williamthayer/Daisy_Board_DC/Daisy Board DC.docx

### Daisy Board DC

Compact, ESP32-powered motor driver with integrated IMU for robotics and IoT projects

Key Features:

- Controls DC motors up to 7A continuous, 10A peak.
- Operates with input voltages between 10V and 28V.
- Compact design (1.2" x 1.8") with various communication options: 5V I2C, CAN bus, GPIO.
- Onboard 6-axis IMU for motion tracking and feedback.

Manufacturer: Wilson Fabrication

### Table of Contents

1. Overview
2. Key Features
3. Specifications
4. Pinouts
5. Functional Description
6. Assembly Notes
7. Ordering Information
8. Contact Information

#### 1. Overview

The Daisy Board DC is a feature-rich, compact motor control solution tailored for robotics and smart projects. Powered by the ESP32-C3 microcontroller, this board integrates CAN bus communication for daisy-chaining multiple devices and I2C for easy expansion with sensors or additional modules.

An onboard 6-axis IMU (LSM6DS3TR-C) provides precise motion tracking and orientation feedback, making the board ideal for robotics applications requiring advanced control. The integrated motor driver (VNH7100BASTR) supports up to 7A continuous current and features current-sensing capabilities for real-time monitoring and control.

The Daisy Board DC is designed for maximum flexibility, with connectors for CAN bus, I2C, and GPIO, and configurable CAN addressing using a 4-position DIP switch. This robust solution is well-suited for IoT devices, smart home systems, and robotics projects requiring efficient motor control in a small footprint.

#### 2. Key Features

- Power: Accepts 10V to 28V input, supporting up to 7A continuous current (10A peak).
- Interfaces:
  - CAN Bus (Low, High, 5V, GND)
  - I2C (SCL, SDA, 5V, GND)
  - GPIO (1 digital, 1 analog, 3.3V, GND)
- Onboard Components:
  - Motor Driver: VNH7100BASTR
  - CAN Transceiver: TJA1050T_CM
  - IMU: LSM6DS3TR-C (6-axis)
  - Microcontroller: ESP32-C3
- Feedback: Current sense resistor and 6-axis IMU for enhanced control.
- Flexibility: Includes a 4-position DIP switch to configure CAN addresses.

#### 3. Specifications

- Input Voltage: 10V–28V
- Max Continuous Current: 7A (10A peak)
- PCB Dimensions: 1.2" x 1.8"
- Temperature Range: -40°C to 85°C
- Pin Connectors:
  - XT30 (power in/out and motor output)
  - J8 header for GPIO2, 5V, and GND
- Capacitor and Connectors:
  - Polarized XT30 connectors and capacitor, clearly labeled for correct orientation.

#### 4. Pinouts

CAN Bus:

- CAN LOW
- CAN HIGH
- 5V
- GND

I2C:

- SCL
- SDA
- 5V
- GND

GPIO:

- Digital Input 1
- Analog Input 1
- 3.3V
- GND

#### 5. Functional Description

The Daisy Board DC provides robust motor control with precise feedback capabilities.

- Motor Driver: The VNH7100BASTR motor driver supports high current loads and features current-sensing capabilities. The sense resistor provides 0.125mA per amp to monitor current.
- Current Sensing: A user-solderable sense resistor enables current feedback, tailored to the user’s maximum current needs.
- 6-axis IMU: The LSM6DS3TR-C IMU provides real-time orientation and motion data for advanced robotics applications.
- Communication:
  - CAN Bus allows daisy-chaining of multiple boards.
  - I2C provides expansion for sensors and additional I/O.
- Configurability: The onboard DIP switch allows quick CAN address changes without firmware updates.

#### 6. Assembly Notes

The PCB comes with the following components pre-assembled:

- Motor driver, CAN transceiver, IMU, and basic passives.

User-solderable components:

- 5V regulator
- ESP32 module
- XT30 connectors (optional: bare wire for cost/space savings)
- Sense resistor and large capacitor for motor driver

Ensure proper orientation of the polarized capacitor and XT30 connectors, which are clearly labeled on the PCB.

#### 7. Ordering Information

- Part Number: DaisyBoardDC-ESP32
- Manufacturer: Wilson Fabrication
- Customization Options: Bare PCB or fully assembled (contact for details).

### 8. Sense Resistor Sizing Guide

The Daisy Board DC features a current feedback system utilizing a sense resistor. The motor driver supplies 0.125 mA per amp to the resistor, generating a voltage that corresponds to the motor current. The target voltage at maximum current should be 3V.

#### Example Calculation

If the motor’s maximum current is 10A:

In this case, a resistor with a value of 2.4kΩ is ideal, but standard resistor values like 2.2kΩ or 2.7kΩ can also be used.

#### Lookup Table

Max Current (A) | Target Voltage (V) | Calculated Resistor (kΩ) | Standard Resistor (kΩ)
5 | 3.0 | 4.8 | 4.7
7 | 3.0 | 3.43 | 3.3 or 3.6
10 | 3.0 | 2.4 | 2.2 or 2.7

#### 9. Contact Information

For inquiries, please contact:

- Email: Lucas@wilsonfabrication.net
- Website: https://wilsonfabrication.com/contact-us/
