williamthayer/Daisy_Board_DC/BOM.xlsx

Comment | Designator | Footprint | JLCPCB Part #（optional）
300 | R9 | R_0805_2012Metric
220 | R8 | R_0805_2012Metric | C17557
220 | R7 | R_0805_2012Metric | C17557
NH-B2020RGBA-HF | LED1 | NHB2020RGBAHF | C2874116
PTV09A-4225F-B104 | R1 | TRIM_PT15NV15-102A1010-S
Arduino_Mini_Socket | A1 | Clone_Pro_Mini_Socket_NoSPH
1k Resistor | R2,R3,R4,R5 | R_0805_2012Metric
Data Out | H8 | Hole
CLK Out | H7 | Hole
L78M05ABDT-TR | IC2 | L78M05ABDTTR | C58069
GND | H2 | Hole
Rsense | R6 | R_Axial_DIN0204_L3.6mm_D1.6mm_P5.08mm_Horizontal
24V | H1 | Hole
CLK IN | H6 | Hole
VNH7100BASTR | IC1 | SOIC127P600X175-16N | C503078
M2 | H4 | Hole
Data In | H5 | Hole
M1 | H3 | Hole
