williamthayer/Daisy_Board_DC/JLCbom.xls

Comment | Designator | Footprint | JLCPCB Part #
10nF | C3 | 0805 | C1710
VNH7100BASTR | IC1 | SOIC127P600X175-16N | C503078
8.2k | R1,R13,R14 | 0402 | C25924
Conn_01x02_Pin | J6 | JST_SH_BM02B-SRSS-TB_1x02-1MP_P1.00mm_Vertical | C160402
Conn_01x03_Pin | J5 | JST_SH_SM03B-SRSS-TB_1x03-1MP_P1.00mm_Horizontal | C160403
SM04B-SRSS-TB | J1,J2 | JST_SH_SM04B-SRSS-TB_1x04-1MP_P1.00mm_Horizontal | C160404
TJA1050T_CM | IC2 | SOIC127P600X175-8N | C19723770
100nF | C2,C6 | 0805 | C49678
DSHP04TJGER | SW1 | SW_DIP_SPSTx04_Slide_KingTek_DSHP04TJ_W5.25mm_P1.27mm_JPin | C3293150
2.2k | R11 | 0402 | C25879
30pF | C4,C5 | 0805 | C107114
120 | R7,R8 | 0402 | C25079
NH-B2020RGBA-HF | LED1 | NHB2020RGBAHF | C2874116
165 | R9 | 0402 | C166668
1.1k | R12,R2,R3,R4,R5 | 0402 | C25860
3.9k | R10 | 0402 | C51721
