williamthayer/Daisy_Board_DC/Arduino_Motor_Shield Knee Shape Rev 3/DC_ESP32_Motor_Board_CAN.step

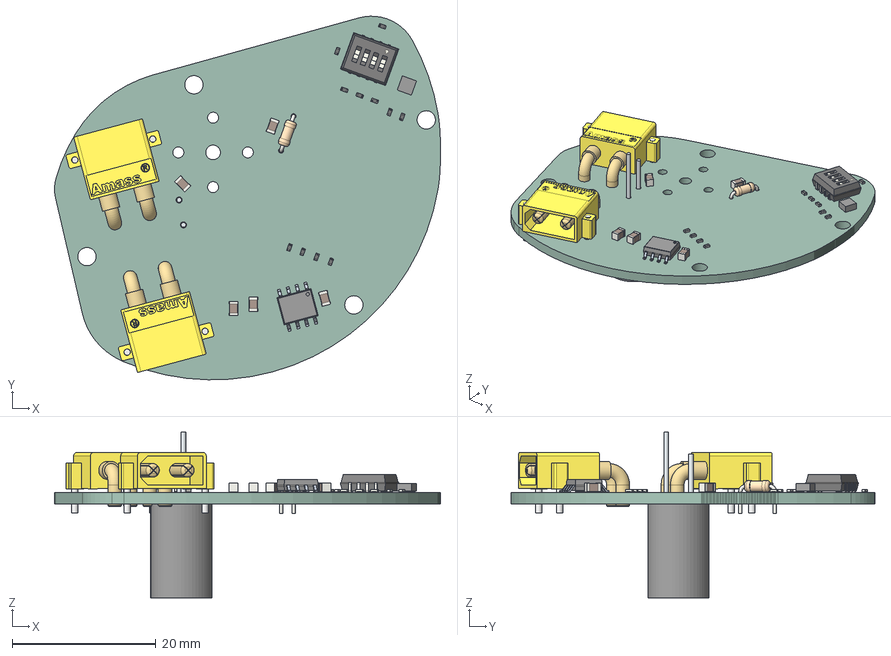
[picture p1: CAD file, 2024-10-24]
Arduino_Motor_Shield Knee Shape Rev 3/DC_ESP32_Motor_Board_CAN.step
53.6 x 50.5 x 23.0 mm
Amass_XT30PW-M_pcb solder x 2
R_0402_1005Metric x 11
C_0805_2012Metric x 5
R_Axial_DIN0204_L36mm_D16mm_P508mm_Horizontal
ASSEMBLY x 3
SW_DIP_SPSTx04_Slide_KingTek_DSHP04TJ_W525mm_P127mm_JPin
_autosave-Arduino_Motor_Shield_PCB
