williamthayer/Daisy_Board_DC/DC_ESP32_Motor_Board_CAN.kicad_pcb

## KiCad design DC_ESP32_Motor_Board_CAN.kicad_pcb (2025-01-15)

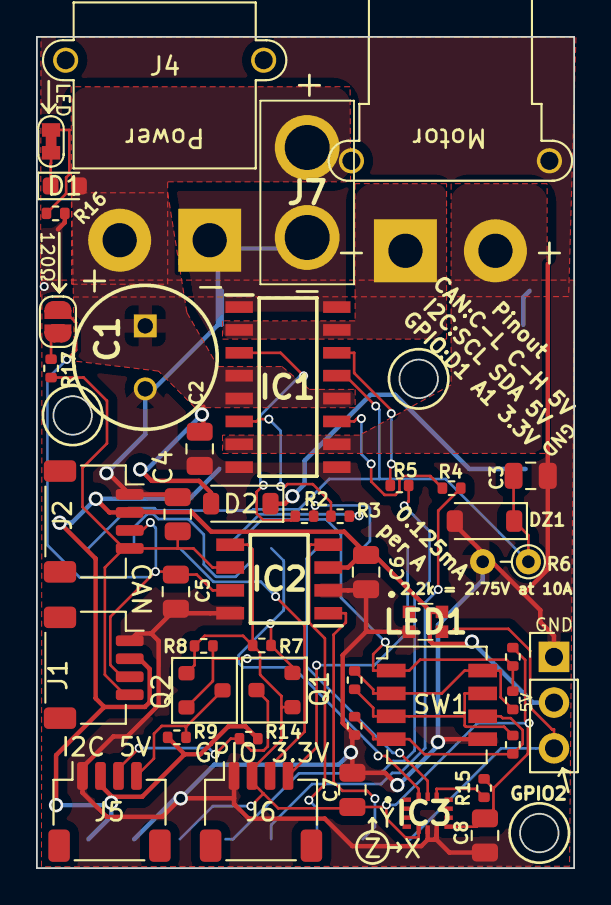
[picture p2: board DC_ESP32_Motor_Board_CAN.kicad_pcb from above]

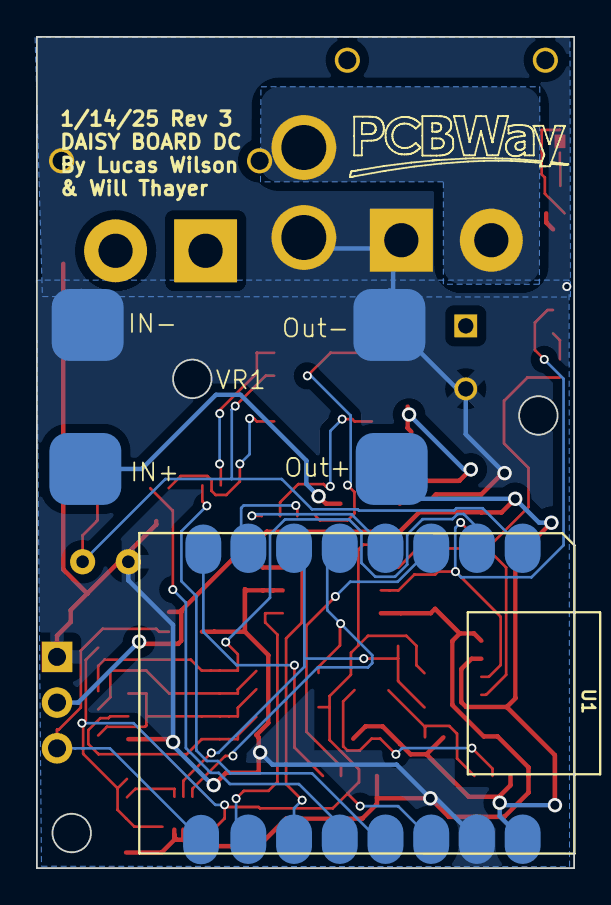
[picture p3: board DC_ESP32_Motor_Board_CAN.kicad_pcb from below]

Board: 2 copper layers, 29.8 x 46.2 mm, 47 parts (2 on the bottom side), 35 nets.

Parts:
C1: EEU-FK1E271; CAPPRD350W65D800H1300
C2, C6, C7, C8: 100nF; C_0805_2012Metric
C3: 10nF; C_0805_2012Metric
C4, C5: 30pF; C_0805_2012Metric
D1: KT-0603R; LED_0603_1608Metric
D2: SS34; D_SOD-123
DZ1: MM1Z3V3; D_SOD-123
IC1: VNH7100BASTR; SOIC127P600X175-16N
IC2: TJA1050T_CM; SOIC127P600X175-8N
IC3: LSM6DS3TR-C; LSM6DS3USTR
J1, J2, J5, J6: SM04B-SRSS-TB; JST_SH_SM04B-SRSS-TB_1x04-1MP_P1.00mm_Horizontal
J3: XT30PB; xt30_90_Female
J4: XT30PB; Xt30 Horizontal
J7: XT30PB
J8: Conn_01x03_Pin; PinHeader_1x03_P2.54mm_Vertical
JP1: SolderJumper_2_Open; SolderJumper-2_P1.3mm_Open_RoundedPad1.0x1.5mm
JP2: SolderJumper_2_Open; Jumper Connected 2 Pin Small
LED1: WS2812C-2020; WS2812C2020
Q1, Q2: BSS138; SOT-23
R1: 22k; R_0402_1005Metric
R2, R3, R4, R5: 1.1k; R_0402_1005Metric
R6: Rsense; R_Axial_DIN0204_L3.6mm_D1.6mm_P2.54mm_Vertical
R7, R8, R9, R10, R13, R14, R15: 10k; R_0402_1005Metric
R11: 4.7k; R_0402_1005Metric
R12: 2.2k; R_0402_1005Metric
R16: 1.5k; R_0402_1005Metric
R17: 120; R_0402_1005Metric
SW1: DSHP04TJGER; SW_DIP_SPSTx04_Slide_Copal_CHS-04A_W5.08mm_P1.27mm_JPin
U1: MOUDLE-SEEEDUINO-XIAO-ESP32C3; ESP32-C3 16 Pin Super Mini
VR1: EY9 reg board

Connections:
+3.3V: C7.1, C8.1, IC2.5 (VREF), IC3.5 (VDDIO), IC3.8 (VDD), J6.2, Q1.1 (G), Q2.1 (G), R7.2, R8.2, R13.1, R15.2, U1.14 (3.3V)
+5V: C6.1, IC2.3 (VCC), J1.2, J2.2, J5.2, J8.2, LED1.4 (VDD), R9.2, R14.2, U1.16 (5V), VR1.2 (Out+)
+24V: C1.1 (+), C2.1, D1.2 (A), D2.2 (A), IC1.4 (VCC_1), IC1.5 (VCC_2), IC1.12 (VCC_3), J4.2, J7.2
/OUTA: IC1.2 (OUTA_1), IC1.15 (OUTA_2), J3.1
/OUTB: IC1.7 (OUTB_1), IC1.10 (OUTB_2), J3.2
/SCL5: J5.4, Q2.3 (D), R9.1
/SDA5: J5.3, Q1.3 (D), R14.1
CANH: C5.1, IC2.7 (CANH), J1.3, J2.3, JP1.2 (B)
CANL: C4.2, IC2.6 (CANL), J1.4, J2.4, R17.1
CANRX: IC2.4 (RXD), U1.11 (PA6_A10_D10_MOSI)
CANTX: IC2.1 (TXD), U1.10 (PA5_A9_D9_MISO)
DipV: R1.2, R13.2, SW1.1, U1.2 (PA4_A1_D1)
GND: C1.2 (-), C2.2, C3.2, C4.1, C5.2, C6.2, C7.2, C8.2, DZ1.2 (A), IC1.1 (GNDA_1), IC1.8 (GNDB_1), IC1.9 (GNDB_2), IC1.16 (GNDA_2), IC2.2 (GND), IC2.8 (S), IC3.6 (GND_1), IC3.7 (GND_2), J1.1, J2.1, J4.1, J5.1, J6.1, J7.1, J8.1, LED1.2 (GND), R6.2, R12.1, R16.1, SW1.5, U1.15 (GND), VR1.1 (Out-), VR1.4 (In-)
GPIO_1: J6.4, U1.8 (PB09_A7_D7_RX)
GPIO_2: J8.3, LED1.3 (DI), U1.9 (PA7_A8_D8_SCK)
GPIO_A: J6.3, U1.3 (PA10_A2_D2)
INA: R2.1, U1.7 (PB08_A6_D6_TX)
INB: R3.1, U1.4 (PA11_A3_D3)
unnamed: D1.1 (K), JP2.2 (B)
unnamed: D2.1 (K), VR1.3 (In+)
unnamed: IC1.3 (INA), R2.2
unnamed: IC1.6 (INB), R3.2
unnamed: IC1.11 (PWM), R4.1
unnamed: IC1.14 (SEL0), R5.1
unnamed: IC3.12 (CS), R15.1
unnamed: JP1.1 (A), R17.2
unnamed: JP2.1 (A), R16.2
unnamed: R1.1, R10.2, SW1.2, SW1.8
unnamed: R10.1, R11.2, SW1.3, SW1.7
unnamed: R11.1, R12.2, SW1.4, SW1.6
PWM: R4.2, U1.12 (PA6_A11_D11)
RSENSE: C3.1, DZ1.1 (K), IC1.13 (CS), R6.1, U1.1 (PA02_A0_D0)
SCL: IC3.13 (SCL), Q2.2 (S), R8.1, U1.6 (PA9_A5_D5_SCL)
SDA: IC3.14 (SDA), Q1.2 (S), R7.1, U1.5 (PA8_A4_D4_SDA)
SEL: R5.2, U1.13 (PA6_A12_D12)
