williamthayer/Daisy_Board_DC/Arduino_Motor_Shield Knee Shape Rev 3/DC_ESP32_Motor_Board_CAN.kicad_pcb

## KiCad design Arduino_Motor_Shield Knee Shape Rev 3/DC_ESP32_Motor_Board_CAN.kicad_pcb (2024-10-24)

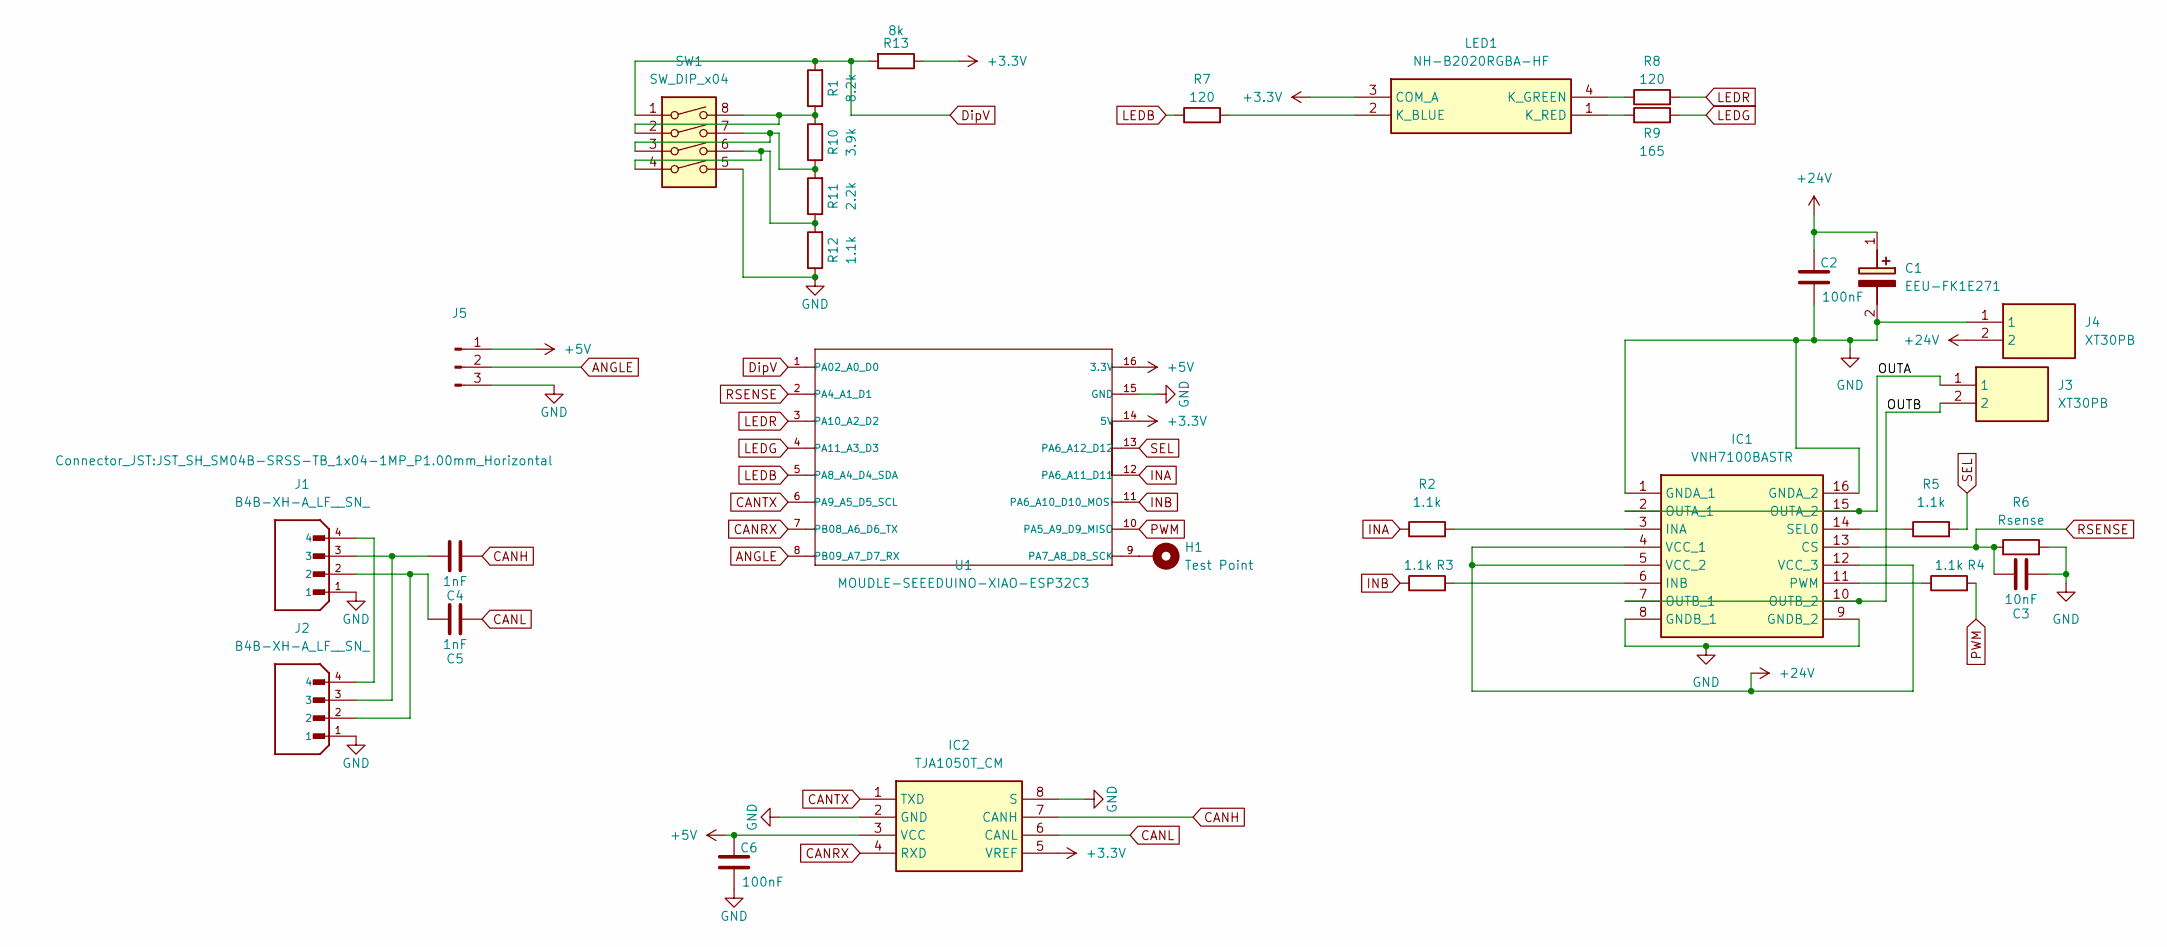
[picture p4: schematic DC_ESP32_Motor_Board_CAN.kicad_sch]

Parts:
C1: EEU-FK1E271; CAPPRD350W65D800H1300; Manufacturer_Part_Number EEU-FK1E271; Mouser Part Number 667-EEU-FK1E271
C2, C6: 100nF; C_0805_2012Metric
C3: 10nF; C_0805_2012Metric
C4, C5: 1nF; C_0805_2012Metric
H1: Test Point; TestPoint_Keystone_5015_Micro-Minature
IC1: VNH7100BASTR; SOIC127P600X175-16N; Manufacturer_Part_Number VNH7100BASTR; Mouser Part Number 511-VNH7100BASTR
IC2: TJA1050T_CM; SOIC127P600X175-8N; Manufacturer_Part_Number TJA1050T/CM; Mouser Part Number N/A
J1, J2: B4B-XH-A_LF__SN_; JST_SH_SM04B-SRSS-TB_1x04-1MP_P1.00mm_Horizontal
J3, J4: XT30PB; AMASS_XT30PW-M_1x02_P2.50mm_Horizontal; Manufacturer_Part_Number XT30PB
J5: Conn_01x03_Pin; JST_SH_SM03B-SRSS-TB_1x03-1MP_P1.00mm_Horizontal
LED1: NH-B2020RGBA-HF; Manufacturer_Part_Number NH-B2020RGBA-HF
R1: 8.2k; R_0402_1005Metric
R2, R3, R4, R5, R12: 1.1k; R_0402_1005Metric
R6: Rsense; R_Axial_DIN0204_L3.6mm_D1.6mm_P5.08mm_Horizontal
R7, R8: 120; R_0402_1005Metric
R9: 165; R_0402_1005Metric
R10: 3.9k; R_0402_1005Metric
R11: 2.2k; R_0402_1005Metric
R13: 8k; R_0402_1005Metric
SW1: SW_DIP_x04; SW_DIP_SPSTx04_Slide_KingTek_DSHP04TJ_W5.25mm_P1.27mm_JPin
U1: MOUDLE-SEEEDUINO-XIAO-ESP32C3; MOUDLE14P-SMD-2.54-21X17.8MM

Connections:
+24V: C1.1 (+), C2.1, IC1.4 (VCC_1), IC1.5 (VCC_2), IC1.12 (VCC_3), J4.2
/OUTA: IC1.2 (OUTA_1), IC1.15 (OUTA_2), J3.1
/OUTB: IC1.7 (OUTB_1), IC1.10 (OUTB_2), J3.2
ANGLE: J5.2, U1.8 (PB09_A7_D7_RX)
CANH: C4.2, IC2.7 (CANH)
CANL: C5.2, IC2.6 (CANL)
CANRX: IC2.4 (RXD), U1.7 (PB08_A6_D6_TX)
CANTX: IC2.1 (TXD), U1.6 (PA9_A5_D5_SCL)
DipV: R1.2, R13.2, SW1.1, U1.1 (PA02_A0_D0)
GND: C1.2 (-), C2.2, C3.2, C6.2, IC1.1 (GNDA_1), IC1.8 (GNDB_1), IC1.9 (GNDB_2), IC1.16 (GNDA_2), IC2.2 (GND), IC2.8 (S), J1.1, J2.1, J4.1, J5.3, R6.2, R12.1, SW1.5, U1.15 (GND)
INA: R2.1, U1.12 (PA6_A11_D11)
INB: R3.1, U1.11 (PA6_A10_D10_MOSI)
LEDB: R7.1, U1.5 (PA8_A4_D4_SDA)
LEDG: R9.2, U1.4 (PA11_A3_D3)
LEDR: R8.2, U1.3 (PA10_A2_D2)
unnamed: C4.1, J1.3, J2.3
unnamed: C5.1, J1.2, J2.2
unnamed: IC1.3 (INA), R2.2
unnamed: IC1.6 (INB), R3.2
unnamed: IC1.11 (PWM), R4.1
unnamed: IC1.14 (SEL0), R5.1
unnamed: J1.4, J2.4
unnamed: LED1.2 (K_BLUE), R7.2
unnamed: LED1.4 (K_GREEN), R8.1
unnamed: LED1.1 (K_RED), R9.1
unnamed: R1.1, R10.2, SW1.2, SW1.8
unnamed: R10.1, R11.2, SW1.3, SW1.7
unnamed: R11.1, R12.2, SW1.4, SW1.6
unnamed: H1.1, U1.9 (PA7_A8_D8_SCK)
PWM: R4.2, U1.10 (PA5_A9_D9_MISO)
RSENSE: C3.1, IC1.13 (CS), R6.1, U1.2 (PA4_A1_D1)
SEL: R5.2, U1.13 (PA6_A12_D12)

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
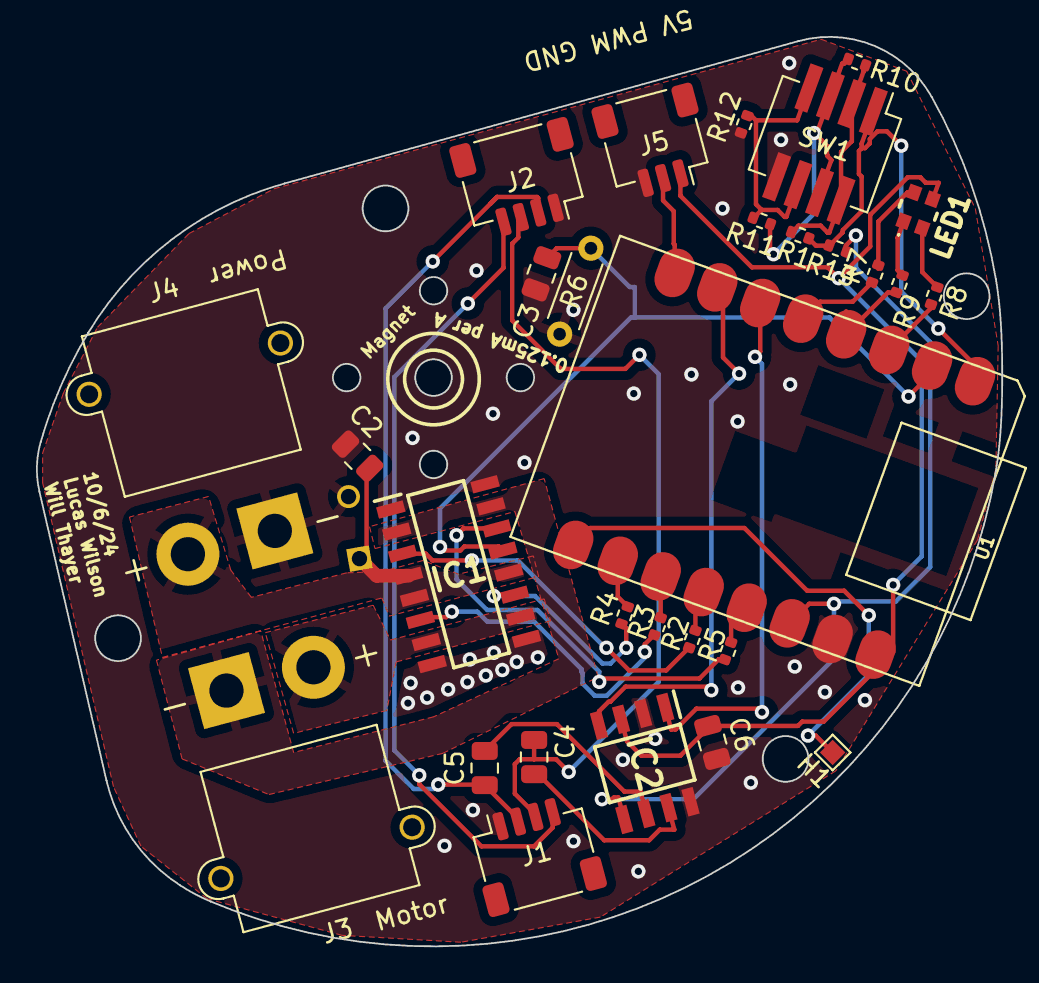
[picture p5: board Arduino_Motor_Shield Knee Shape Rev 3/DC_ESP32_Motor_Board_CAN.kicad_… from above]

Board: 2 copper layers, 53.6 x 50.5 mm, 30 parts (1 on the bottom side), 34 nets.
