williamthayer/Daisy_Board_DC/(commit log)

2024-10-24 Rev A
    [BOM.xlsx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]
2024-10-29 Update with mounting holes
    [DC_ESP32_Motor_Board_CAN.kicad_pcb, DC_ESP32_Motor_Board_CAN.kicad_sch, bom.csv, designators.csv, positions.csv]
2024-11-21 Last Update to PCBWAY
    [DC_ESP32_Motor_Board_CAN.kicad_pcb, DC_ESP32_Motor_Board_CAN.kicad_sch, bom.csv, designators.csv, positions.csv]
2024-11-21 Added DataSheet
    [DC_ESP32_Motor_Board_CAN.kicad_pcb]
2025-01-02 Code Updates
    [DC_ESP32_Motor_Board_CAN.kicad_sch]
2025-01-07 Updates for PCB
    Bigger GPIO2
    Added RGB LED
    Updated xt30s
    Updated xt30 size to fit inline connectors on PCB
    Fixed jst sh connections
    [DC_ESP32_Motor_Board_CAN.kicad_pcb, DC_ESP32_Motor_Board_CAN.kicad_sch]
2025-01-08 Minor Trace Updates
    [DC_ESP32_Motor_Board_CAN.kicad_pcb, bom.csv, designators.csv, positions.csv]
2025-01-15 Newest Update for Review
    Updated do not place parts, and fixed last last few traces. Should be good for ordering
    [DC_ESP32_Motor_Board_CAN.kicad_pcb, DC_ESP32_Motor_Board_CAN.kicad_sch, bom.csv, designators.csv, positions.csv]
